S25-26-CMOS-Detector-Readout-System/S25-26-kicad/S25-26.kicad_pcb

## KiCad design S25-26.kicad_pcb (2025-04-30)

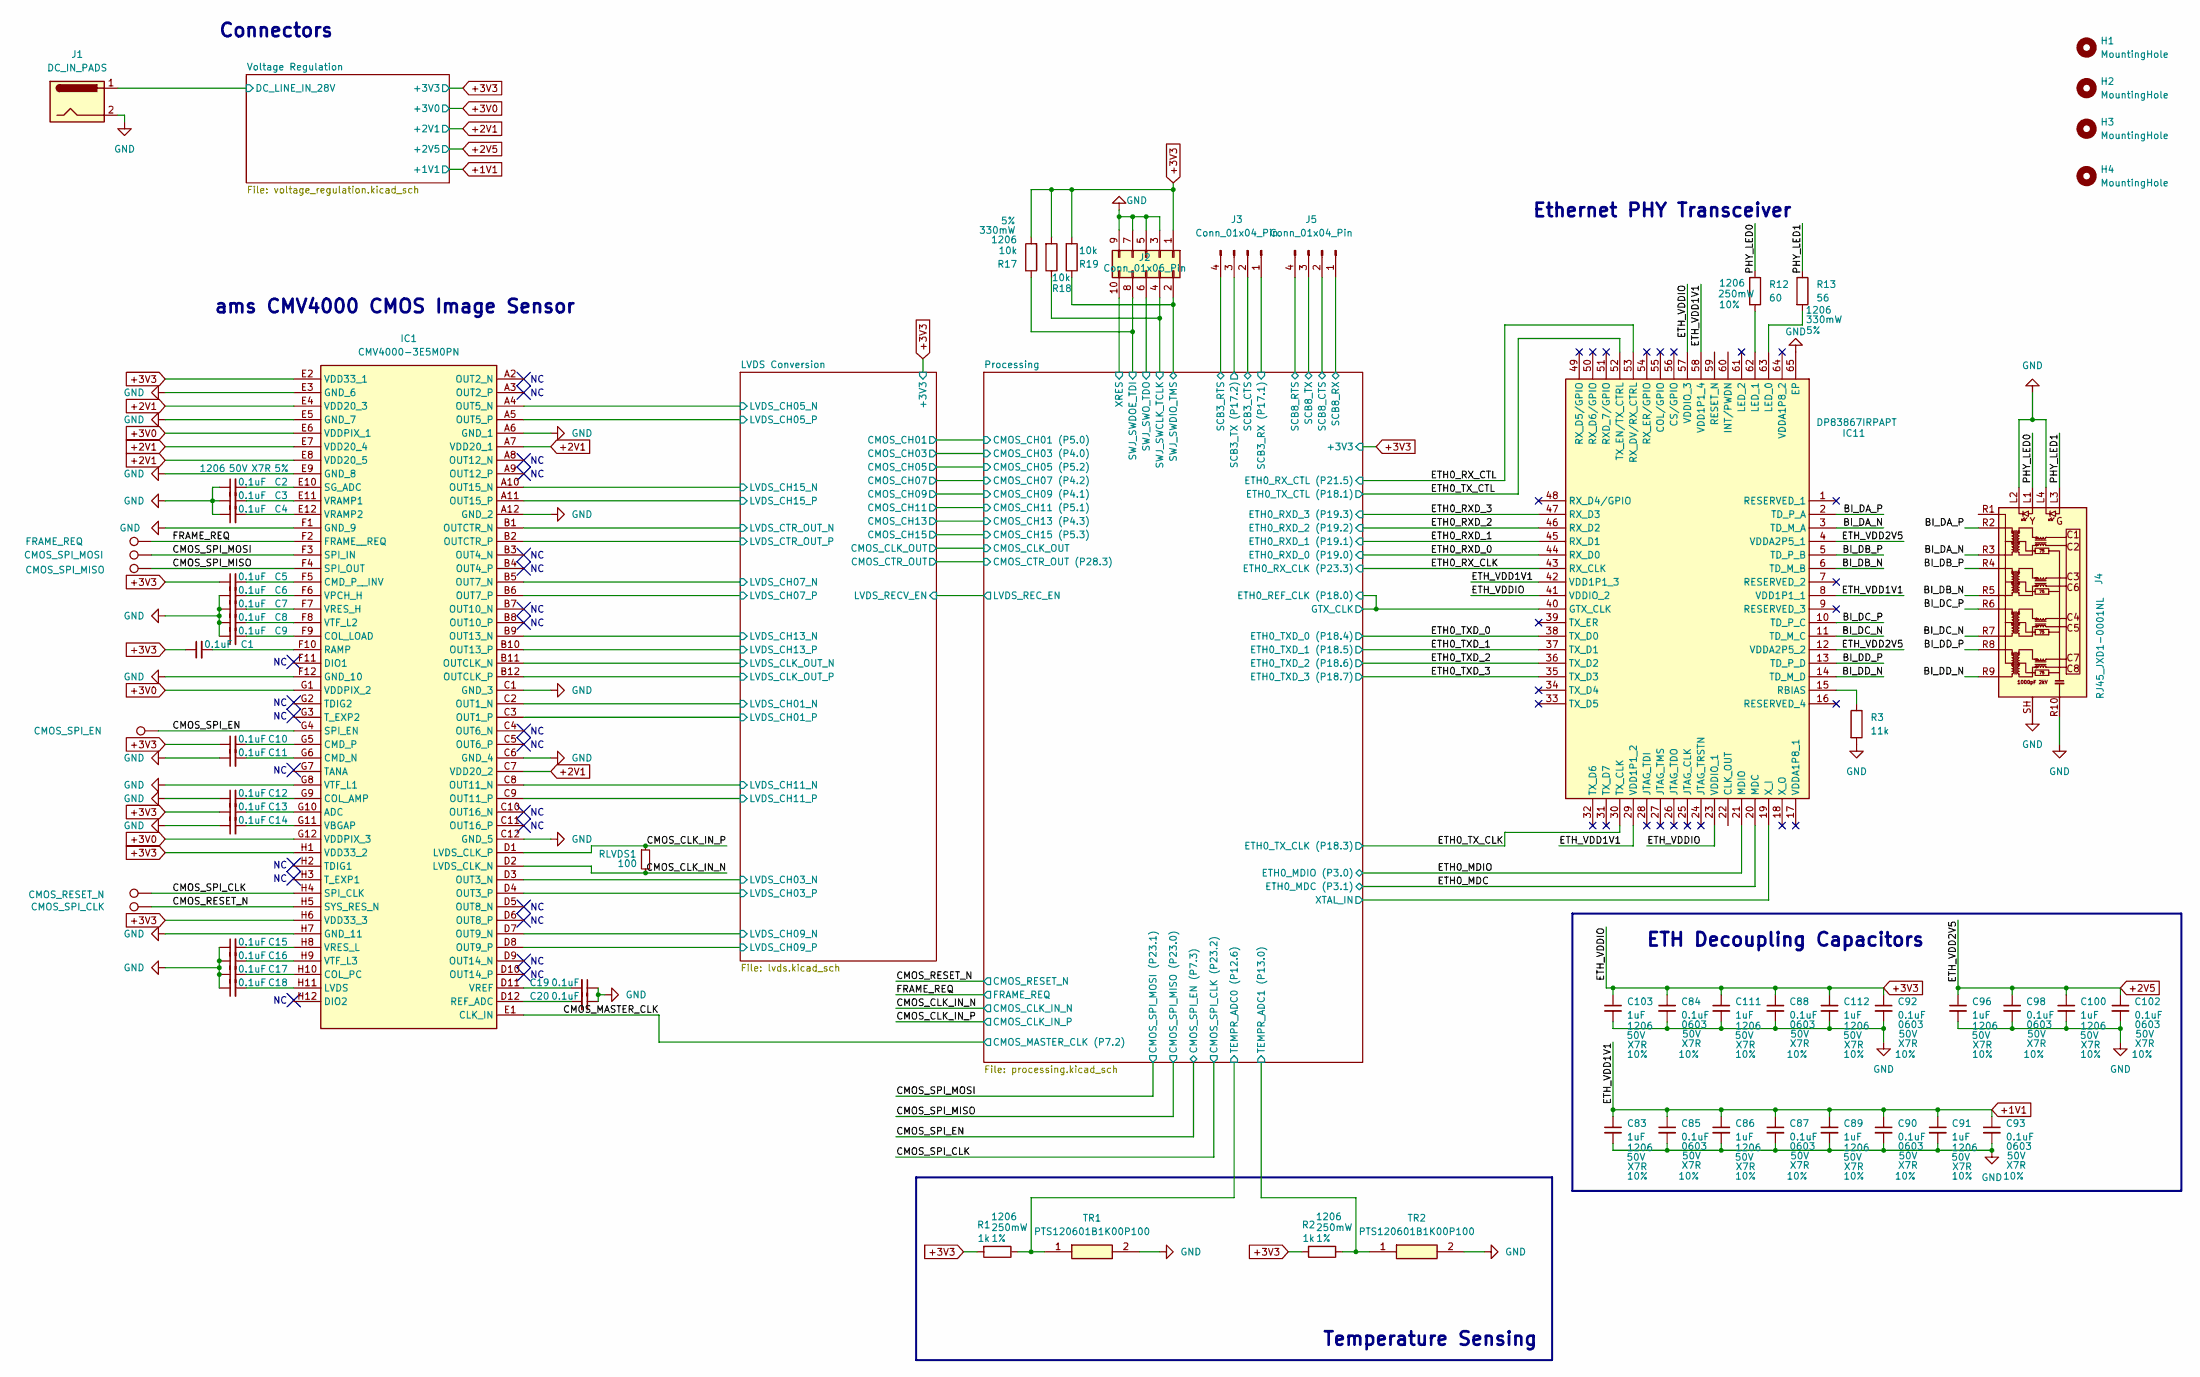
[picture p1: schematic S25-26.kicad_sch, S25-26: CMOS Detector Small Satellite Readout System]

Parts:
C1, C2, C3, C4, C5, C6, C7, C8, C9, C10, C11, C12, C13, C14, C15, C16, C17, C18, C19, C20: 0.1uF; C_1206_3216Metric; Voltage Rating 50V; Tolerance 5%; Mouser Part Number 581-12065C104J4Z2A
C83, C86, C89, C91, C96, C100, C103, C111, C112: 1uF; C_1206_3216Metric; Voltage Rating 50V; Tolerance 10%; Mouser Part Number 963-UMK316B7105KL-T
C84, C85, C87, C88, C90, C92, C93, C98, C102: 0.1uF; C_0603_1608Metric; Voltage Rating 50V; Tolerance 10%; Mouser Part Number 963-UMK107B7104KAHT
CMOS_RESET_N1: CMOS_RESET_N; TestPoint_Pad_2.0x2.0mm
CMOS_SCLK1: CMOS_SPI_CLK; TestPoint_Pad_2.0x2.0mm
CMOS_SPI_EN1: CMOS_SPI_EN; TestPoint_Pad_2.0x2.0mm
CMOS_SPI_MISO1: CMOS_SPI_MISO; TestPoint_Pad_2.0x2.0mm
CMOS_SPI_MOSI1: CMOS_SPI_MOSI; TestPoint_Pad_2.0x2.0mm
FRAME_REQ1: FRAME_REQ; TestPoint_Pad_2.0x2.0mm
H1, H2, H3, H4: MountingHole; MountingHole_2.7mm_Keepout
IC1: CMV4000-3E5M0PN; CMV40003E5M0PN_Socket; Manufacturer_Part_Number CMV4000-3E5M0PN
IC11: DP83867IRPAPT; QFP50P1200X1200X120-65N; Mouser Part Number 595-DP83867IRPAPT
J1: DC_IN_PADS; SolderWire-2sqmm_1x02_P7.8mm_D2mm_OD3.9mm
J2: Conn_01x06_Pin; PinHeader_2x05_P1.27mm_Vertical_SMD
J3, J5: Conn_01x04_Pin; PinHeader_1x04_P2.54mm_Vertical
J4: RJ45_JXD1-0001NL; Digikey Part Number 553-3266-ND
R1, R2: 1k; R_1206_3216Metric; Power Rating 250mW; Tolerance 1%; Mouser Part Number 71-RCA12061K00FKEA
R3: 11k; R_1206_3216Metric
R12: 60; R_1206_3216Metric; Power Rating 250mW; Tolerance 10%; Mouser Part Number 71-CRCW120660R0KNAIF
R13: 56; R_1206_3216Metric; Power Rating 330mW; Tolerance 5%; Mouser Part Number 667-ERJ-T08J560V
R17, R18, R19: 10k; R_1206_3216Metric; Power Rating 330mW; Tolerance 5%; Mouser Part Number 667-ERJ-T08J103V
RLVDS1: 100; R_0603_1608Metric; Power Rating 0.2W; Tolerance 1%; Mouser Part Number 667-ERJ-P03F1000V
TR1, TR2: PTS120601B1K00P100; RESC3016X65N; Manufacturer_Part_Number PTS120601B1K00P100; Mouser Part Number 594-PTS120601B1K00P

Connections:
+1V1: C83.1, C85.1, C86.1, C87.1, C89.1, C90.1, C91.1, C93.1, IC11.8 (VDD1P1_1), IC11.29 (VDD1P1_2), IC11.42 (VDD1P1_3), IC11.58 (VDD1P1_4); also elsewhere on the board
+2V1: IC1.A7 (VDD20_1), IC1.C7 (VDD20_2), IC1.E4 (VDD20_3), IC1.E7 (VDD20_4), IC1.E8 (VDD20_5); also elsewhere on the board
+2V5: C96.1, C98.1, C100.1, C102.1, IC11.4 (VDDA2P5_1), IC11.12 (VDDA2P5_2); also elsewhere on the board
+3V0: IC1.E6 (VDDPIX_1), IC1.G1 (VDDPIX_2), IC1.G12 (VDDPIX_3); also elsewhere on the board
+3V3: C1.1, C5.1, C10.1, C13.1, C84.1, C88.1, C92.1, C103.1, C111.1, C112.1, IC1.E2 (VDD33_1), IC1.H1 (VDD33_2), IC1.H6 (VDD33_3), IC11.23 (VDDIO_1), IC11.41 (VDDIO_2), IC11.57 (VDDIO_3), J2.1, R1.2, R2.2, R17.2, R18.2, R19.2; also elsewhere on the board
/BI_DA_N: IC11.3 (TD_M_A), J4.R3 (TD1-)
/BI_DA_P: IC11.2 (TD_P_A), J4.R2 (TD1+)
/BI_DB_N: IC11.6 (TD_M_B), J4.R5 (TD2-)
/BI_DB_P: IC11.5 (TD_P_B), J4.R4 (TD2+)
/BI_DC_N: IC11.11 (TD_M_C), J4.R7 (TD3-)
/BI_DC_P: IC11.10 (TD_P_C), J4.R6 (TD3+)
/BI_DD_N: IC11.14 (TD_M_D), J4.R9 (TD4-)
/BI_DD_P: IC11.13 (TD_P_D), J4.R8 (TD4+)
/CMOS_CLK_IN_N: IC1.D2 (LVDS_CLK_N), RLVDS1.2; also elsewhere on the board
/CMOS_CLK_IN_P: IC1.D1 (LVDS_CLK_P), RLVDS1.1; also elsewhere on the board
/CMOS_MASTER_CLK: IC1.E1 (CLK_IN); also elsewhere on the board
/CMOS_RESET_N: CMOS_SCLK1.1, IC1.H5 (SYS_RES_N); also elsewhere on the board
/CMOS_SPI_CLK: CMOS_RESET_N1.1, IC1.H4 (SPI_CLK); also elsewhere on the board
/CMOS_SPI_EN: CMOS_SPI_EN1.1, IC1.G4 (SPI_EN); also elsewhere on the board
/CMOS_SPI_MISO: CMOS_SPI_MISO1.1, IC1.F4 (SPI_OUT); also elsewhere on the board
/CMOS_SPI_MOSI: CMOS_SPI_MOSI1.1, IC1.F3 (SPI_IN); also elsewhere on the board
/ETH0_MDC: IC11.20 (MDC); also elsewhere on the board
/ETH0_MDIO: IC11.21 (MDIO); also elsewhere on the board
/ETH0_RXD_0: IC11.44 (RX_D0); also elsewhere on the board
/ETH0_RXD_1: IC11.45 (RX_D1); also elsewhere on the board
/ETH0_RXD_2: IC11.46 (RX_D2); also elsewhere on the board
/ETH0_RXD_3: IC11.47 (RX_D3); also elsewhere on the board
/ETH0_RX_CLK: IC11.43 (RX_CLK); also elsewhere on the board
/ETH0_RX_CTL: IC11.53 (RX_DV/RX_CTRL); also elsewhere on the board
/ETH0_TXD_0: IC11.38 (TX_D0); also elsewhere on the board
/ETH0_TXD_1: IC11.37 (TX_D1); also elsewhere on the board
/ETH0_TXD_2: IC11.36 (TX_D2); also elsewhere on the board
/ETH0_TXD_3: IC11.35 (TX_D3); also elsewhere on the board
/ETH0_TX_CLK: IC11.30 (TX_CLK); also elsewhere on the board
/ETH0_TX_CTL: IC11.52 (TX_EN/TX_CTRL); also elsewhere on the board
/FRAME_REQ: FRAME_REQ1.1, IC1.F2 (FRAME__REQ); also elsewhere on the board
/LVDS Conversion/LVDS_CH01_N: IC1.C2 (OUT1_N); also elsewhere on the board
/LVDS Conversion/LVDS_CH01_P: IC1.C3 (OUT1_P); also elsewhere on the board
/LVDS Conversion/LVDS_CH03_N: IC1.D3 (OUT3_N); also elsewhere on the board
/LVDS Conversion/LVDS_CH03_P: IC1.D4 (OUT3_P); also elsewhere on the board
/LVDS Conversion/LVDS_CH05_N: IC1.A4 (OUT5_N); also elsewhere on the board
/LVDS Conversion/LVDS_CH05_P: IC1.A5 (OUT5_P); also elsewhere on the board
/LVDS Conversion/LVDS_CH07_N: IC1.B5 (OUT7_N); also elsewhere on the board
/LVDS Conversion/LVDS_CH07_P: IC1.B6 (OUT7_P); also elsewhere on the board
/LVDS Conversion/LVDS_CH09_N: IC1.D7 (OUT9_N); also elsewhere on the board
/LVDS Conversion/LVDS_CH09_P: IC1.D8 (OUT9_P); also elsewhere on the board
/LVDS Conversion/LVDS_CH11_N: IC1.C8 (OUT11_N); also elsewhere on the board
/LVDS Conversion/LVDS_CH11_P: IC1.C9 (OUT11_P); also elsewhere on the board
/LVDS Conversion/LVDS_CH13_N: IC1.B9 (OUT13_N); also elsewhere on the board
/LVDS Conversion/LVDS_CH13_P: IC1.B10 (OUT13_P); also elsewhere on the board
/LVDS Conversion/LVDS_CH15_N: IC1.A10 (OUT15_N); also elsewhere on the board
/LVDS Conversion/LVDS_CH15_P: IC1.A11 (OUT15_P); also elsewhere on the board
/LVDS Conversion/LVDS_CLK_OUT_N: IC1.B11 (OUTCLK_N); also elsewhere on the board
/LVDS Conversion/LVDS_CLK_OUT_P: IC1.B12 (OUTCLK_P); also elsewhere on the board
/LVDS Conversion/LVDS_CTR_OUT_N: IC1.B1 (OUTCTR_N); also elsewhere on the board
/LVDS Conversion/LVDS_CTR_OUT_P: IC1.B2 (OUTCTR_P); also elsewhere on the board
/PHY_LED0: J4.L1, R12.1
/PHY_LED1: J4.L3, R13.1
/Processing/ETH0_REF_CLK (P18.0): IC11.40 (GTX_CLK); also elsewhere on the board
/Processing/SCB3_CTS: J3.2; also elsewhere on the board
/Processing/SCB3_RTS: J3.4; also elsewhere on the board
/Processing/SCB3_RX (P17.1): J3.1; also elsewhere on the board
/Processing/SCB3_TX (P17.2): J3.3; also elsewhere on the board
/Processing/SCB8_CTS: J5.2; also elsewhere on the board
/Processing/SCB8_RTS: J5.4; also elsewhere on the board
/Processing/SCB8_RX: J5.1; also elsewhere on the board
/Processing/SCB8_TX: J5.3; also elsewhere on the board
/Processing/SWJ_SWCLK_TCLK: J2.4, R18.1; also elsewhere on the board
/Processing/SWJ_SWDIO_TMS: J2.2, R19.1; also elsewhere on the board
/Processing/SWJ_SWDOE_TDI: J2.8, R17.1; also elsewhere on the board
/Processing/SWJ_SWO_TDO: J2.6; also elsewhere on the board
/Processing/TEMPR_ADC0 (P12.6): R1.1, TR1.1; also elsewhere on the board
/Processing/TEMPR_ADC1 (P13.0): R2.1, TR2.1; also elsewhere on the board
/Processing/XRES: J2.10; also elsewhere on the board
/Processing/XTAL_IN: IC11.19 (X_I); also elsewhere on the board
/Voltage Regulation/DC_LINE_IN_28V: J1.1; also elsewhere on the board
GND: C2.1, C3.1, C4.1, C6.1, C7.1, C8.1, C9.1, C11.1, C12.1, C14.1, C15.1, C16.1, C17.1, C18.1, C19.1, C20.1, C83.2, C84.2, C85.2, C86.2, C87.2, C88.2, C89.2, C90.2, C91.2, C92.2, C93.2, C96.2, C98.2, C100.2, C102.2, C103.2, C111.2, C112.2, IC1.A6 (GND_1), IC1.A12 (GND_2), IC1.C1 (GND_3), IC1.C6 (GND_4), IC1.C12 (GND_5), IC1.E3 (GND_6), IC1.E5 (GND_7), IC1.E9 (GND_8), IC1.F1 (GND_9), IC1.F12 (GND_10), IC1.G8 (VTF_L1), IC1.H7 (GND_11), IC11.65 (EP), J1.2, J2.3, J2.5, J2.7, J2.9, J4.L2, J4.L4, J4.R10 (GND), J4.SH, R3.2, TR1.2, TR2.2; also elsewhere on the board
unnamed: C13.2, IC1.G10 (ADC)
unnamed: C11.2, IC1.G6 (CMD_N)
unnamed: C10.2, IC1.G5 (CMD_P)
unnamed: C5.2, IC1.F5 (CMD_P__INV)
unnamed: C12.2, IC1.G9 (COL_AMP)
unnamed: C9.2, IC1.F9 (COL_LOAD)
unnamed: C17.2, IC1.H10 (COL_PC)
unnamed: C18.2, IC1.H11 (LVDS)
unnamed: C1.2, IC1.F10 (RAMP)
unnamed: C20.2, IC1.D12 (REF_ADC)
unnamed: C2.2, IC1.E10 (SG_ADC)
unnamed: C14.2, IC1.G11 (VBGAP)
unnamed: C6.2, IC1.F6 (VPCH_H)
unnamed: C3.2, IC1.E11 (VRAMP1)
unnamed: C4.2, IC1.E12 (VRAMP2)
unnamed: C19.2, IC1.D11 (VREF)
unnamed: C7.2, IC1.F7 (VRES_H)
unnamed: C15.2, IC1.H8 (VRES_L)
unnamed: C8.2, IC1.F8 (VTF_L2)
unnamed: C16.2, IC1.H9 (VTF_L3)
unnamed: IC11.63 (LED_0), R13.2
unnamed: IC11.62 (LED_1), R12.2
unnamed: IC11.15 (RBIAS), R3.1

Notes on the sheet:
ams CMV4000 CMOS Image Sensor
Ethernet PHY Transceiver
Connectors
ETH Decoupling Capacitors
Temperature Sensing

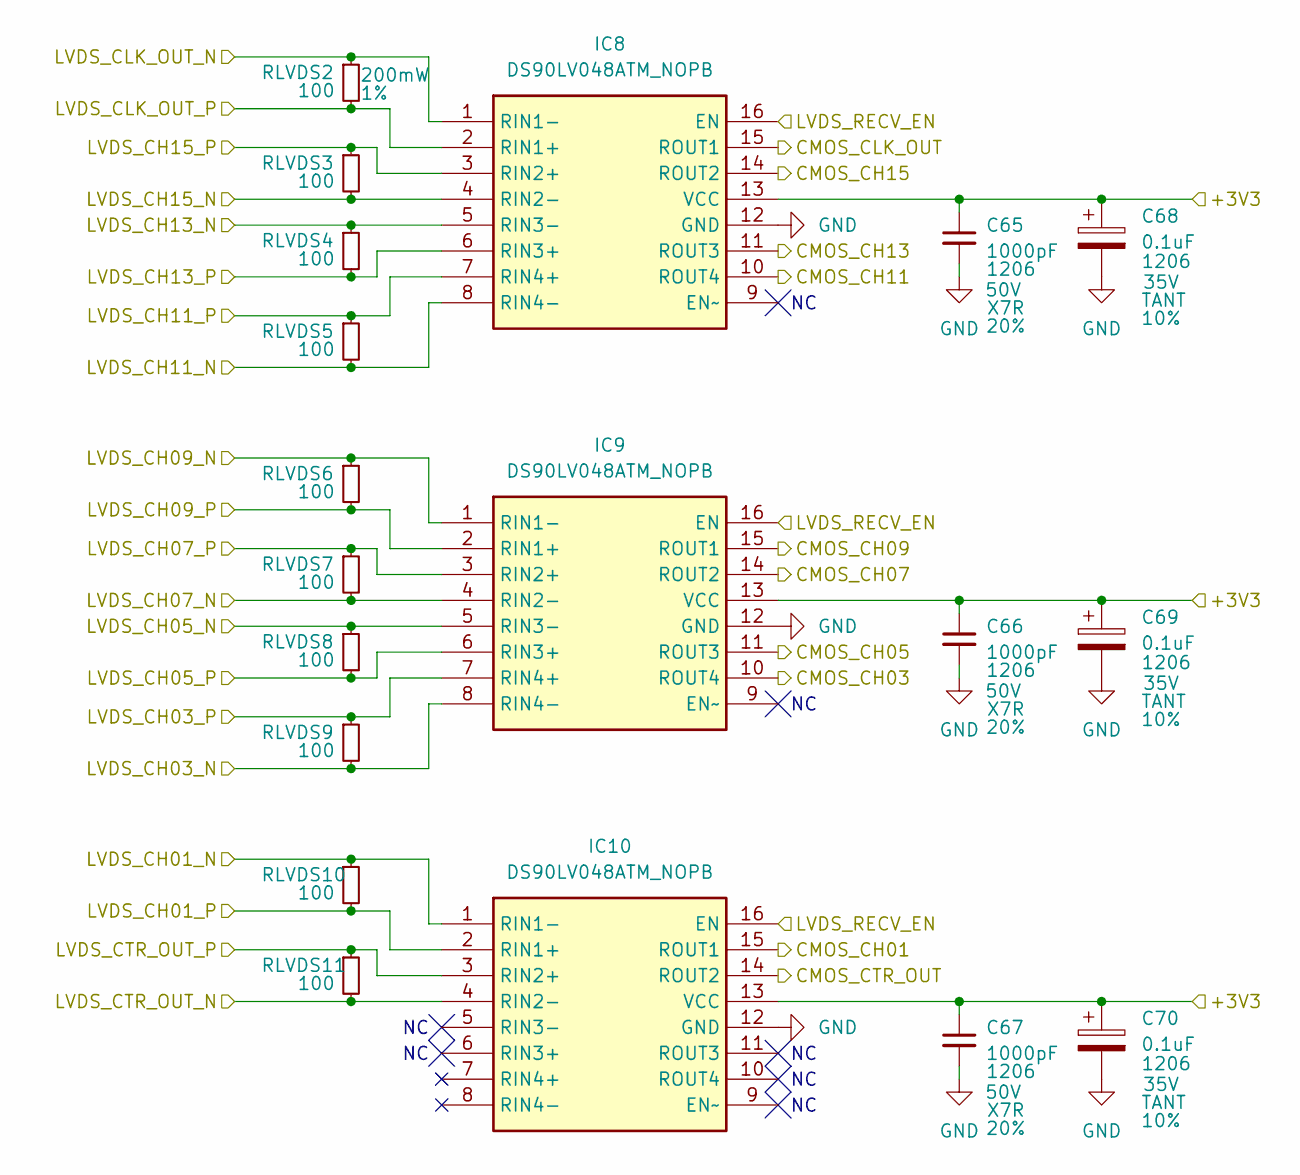
[picture p2: schematic lvds.kicad_sch]

Parts:
C65, C66, C67: 1000pF; C_1206_3216Metric; Voltage Rating 50V; Tolerance 20%; Mouser Part Number 80-C1206C102M5RACTM
C68, C69, C70: 0.1uF; C_1206_3216Metric; Voltage Rating 35V; Tolerance 10%; Mouser Part Number 581-TAJA104K035SNJ
IC8, IC9, IC10: DS90LV048ATM_NOPB; SOIC127P600X175-16N; Manufacturer_Part_Number DS90LV048ATM/NOPB; Mouser Part Number :926-DS90LV048ATMNOPB
RLVDS2: 100; R_0603_1608Metric; Power Rating 200mW; Tolerance 1%; Mouser Part Number 667-ERJ-P03F1000V
RLVDS3, RLVDS4, RLVDS5, RLVDS6, RLVDS7, RLVDS8, RLVDS9, RLVDS10, RLVDS11: 100; R_0603_1608Metric; Power Rating 0.2W; Tolerance 1%; Mouser Part Number 667-ERJ-P03F1000V

Connections:
+3V3: C65.1, C66.1, C67.1, C68.1, C69.1, C70.1, IC8.13 (VCC), IC9.13 (VCC), IC10.13 (VCC); also elsewhere on the board
/LVDS Conversion/CMOS_CH01: IC10.15 (ROUT1); also elsewhere on the board
/LVDS Conversion/CMOS_CH03: IC9.10 (ROUT4); also elsewhere on the board
/LVDS Conversion/CMOS_CH05: IC9.11 (ROUT3); also elsewhere on the board
/LVDS Conversion/CMOS_CH07: IC9.14 (ROUT2); also elsewhere on the board
/LVDS Conversion/CMOS_CH09: IC9.15 (ROUT1); also elsewhere on the board
/LVDS Conversion/CMOS_CH11: IC8.10 (ROUT4); also elsewhere on the board
/LVDS Conversion/CMOS_CH13: IC8.11 (ROUT3); also elsewhere on the board
/LVDS Conversion/CMOS_CH15: IC8.14 (ROUT2); also elsewhere on the board
/LVDS Conversion/CMOS_CLK_OUT: IC8.15 (ROUT1); also elsewhere on the board
/LVDS Conversion/CMOS_CTR_OUT: IC10.14 (ROUT2); also elsewhere on the board
/LVDS Conversion/LVDS_CH01_N: IC10.1 (RIN1-), RLVDS10.1; also elsewhere on the board
/LVDS Conversion/LVDS_CH01_P: IC10.2 (RIN1+), RLVDS10.2; also elsewhere on the board
/LVDS Conversion/LVDS_CH03_N: IC9.8 (RIN4-), RLVDS9.2; also elsewhere on the board
/LVDS Conversion/LVDS_CH03_P: IC9.7 (RIN4+), RLVDS9.1; also elsewhere on the board
/LVDS Conversion/LVDS_CH05_N: IC9.5 (RIN3-), RLVDS8.1; also elsewhere on the board
/LVDS Conversion/LVDS_CH05_P: IC9.6 (RIN3+), RLVDS8.2; also elsewhere on the board
/LVDS Conversion/LVDS_CH07_N: IC9.4 (RIN2-), RLVDS7.2; also elsewhere on the board
/LVDS Conversion/LVDS_CH07_P: IC9.3 (RIN2+), RLVDS7.1; also elsewhere on the board
/LVDS Conversion/LVDS_CH09_N: IC9.1 (RIN1-), RLVDS6.1; also elsewhere on the board
/LVDS Conversion/LVDS_CH09_P: IC9.2 (RIN1+), RLVDS6.2; also elsewhere on the board
/LVDS Conversion/LVDS_CH11_N: IC8.8 (RIN4-), RLVDS5.2; also elsewhere on the board
/LVDS Conversion/LVDS_CH11_P: IC8.7 (RIN4+), RLVDS5.1; also elsewhere on the board
/LVDS Conversion/LVDS_CH13_N: IC8.5 (RIN3-), RLVDS4.1; also elsewhere on the board
/LVDS Conversion/LVDS_CH13_P: IC8.6 (RIN3+), RLVDS4.2; also elsewhere on the board
/LVDS Conversion/LVDS_CH15_N: IC8.4 (RIN2-), RLVDS3.2; also elsewhere on the board
/LVDS Conversion/LVDS_CH15_P: IC8.3 (RIN2+), RLVDS3.1; also elsewhere on the board
/LVDS Conversion/LVDS_CLK_OUT_N: IC8.1 (RIN1-), RLVDS2.1; also elsewhere on the board
/LVDS Conversion/LVDS_CLK_OUT_P: IC8.2 (RIN1+), RLVDS2.2; also elsewhere on the board
/LVDS Conversion/LVDS_CTR_OUT_N: IC10.4 (RIN2-), RLVDS11.2; also elsewhere on the board
/LVDS Conversion/LVDS_CTR_OUT_P: IC10.3 (RIN2+), RLVDS11.1; also elsewhere on the board
/LVDS Conversion/LVDS_RECV_EN: IC8.16 (EN), IC9.16 (EN), IC10.16 (EN); also elsewhere on the board
GND: C65.2, C66.2, C67.2, C68.2, C69.2, C70.2, IC8.12 (GND), IC9.12 (GND), IC10.12 (GND); also elsewhere on the board

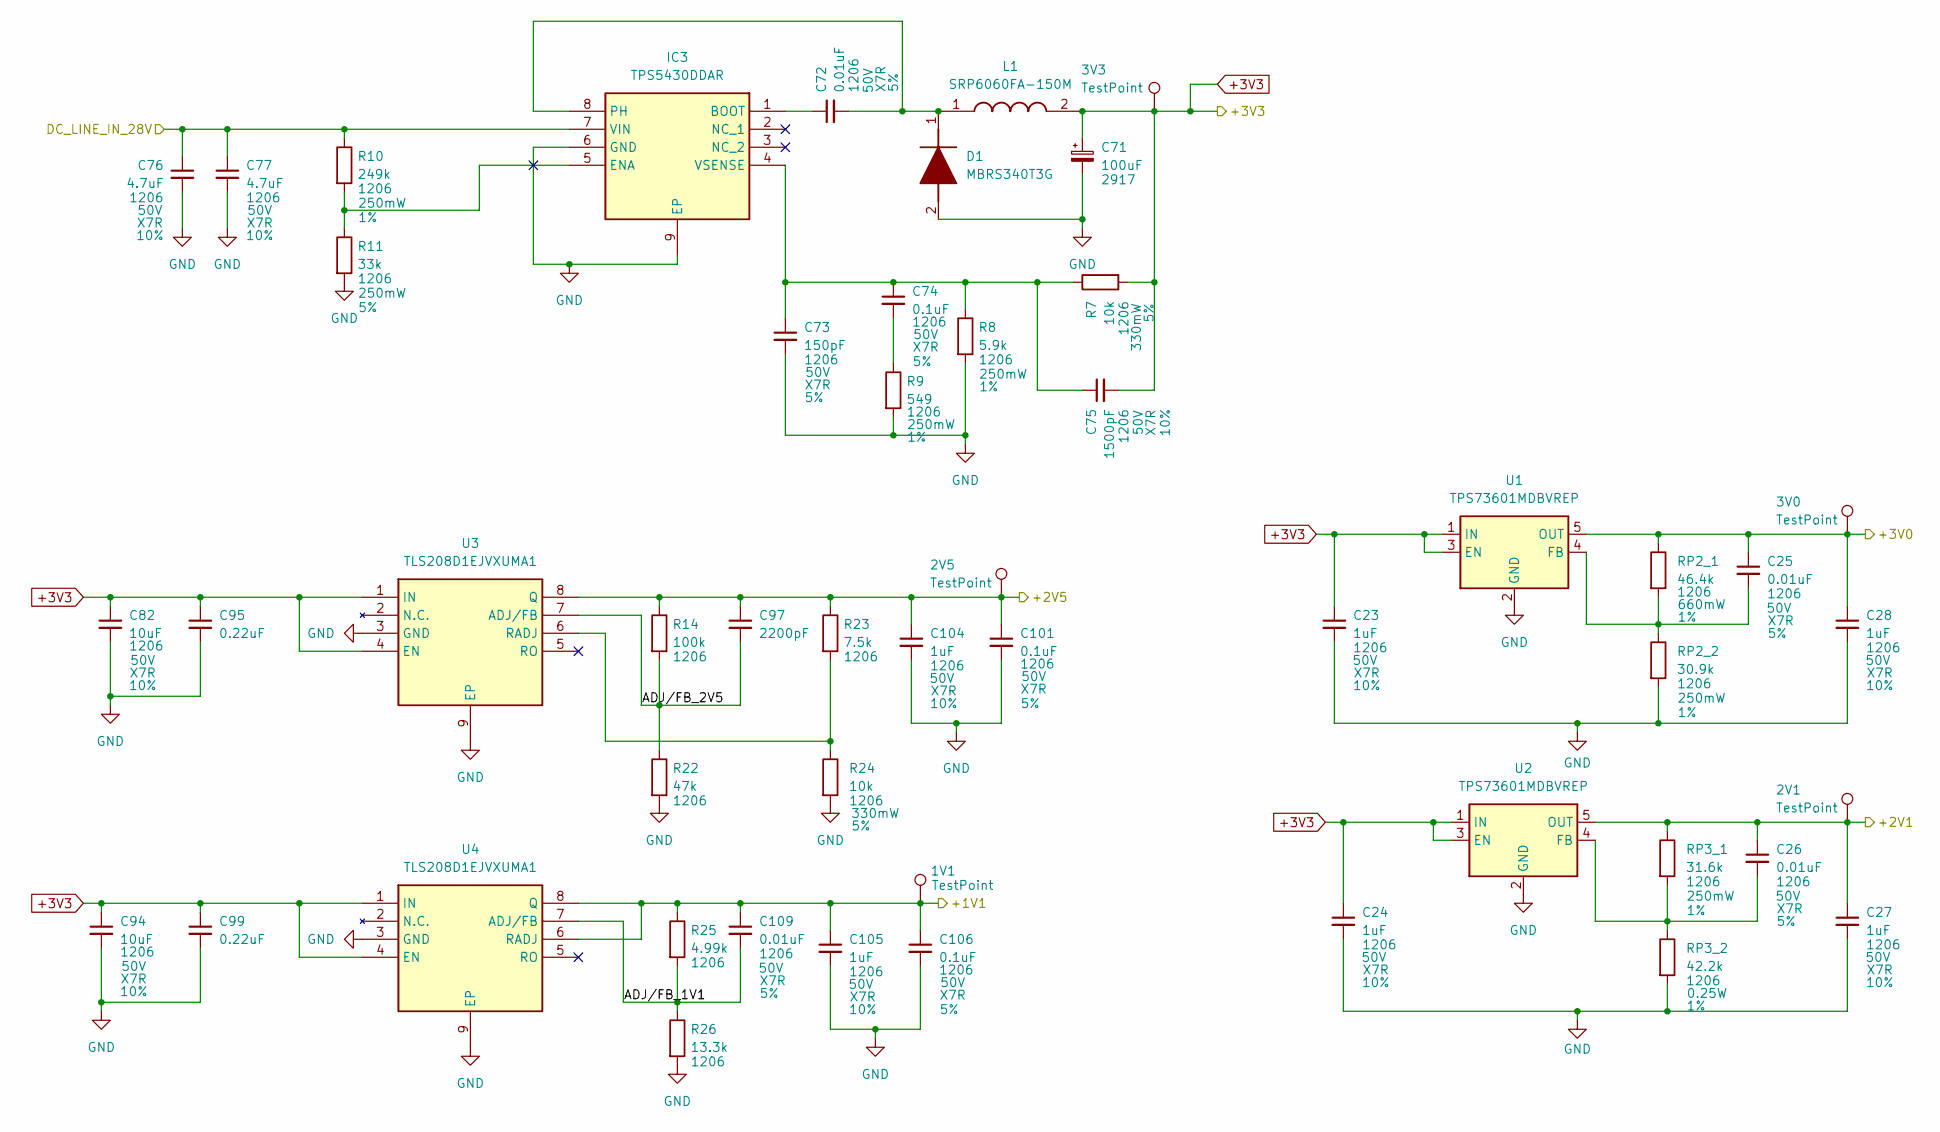
[picture p3: schematic voltage_regulation.kicad_sch]

Parts:
1V1, 2V1, 2V5, 3V0, 3V3: TestPoint; TestPoint_Pad_D1.0mm
C23, C24, C27, C28, C104, C105: 1uF; C_1206_3216Metric; Voltage Rating 50V; Tolerance 10%; Mouser Part Number 963-UMK316B7105KL-T
C25, C26, C72, C109: 0.01uF; C_1206_3216Metric; Voltage Rating 50V; Tolerance 5%; Mouser Part Number 581-12065C103J4T4A
C71: 100uF; CP_EIA-7343-15_Kemet-W; Mouser Part Number 74-293D107X9010D2TE3
C73: 150pF; C_1206_3216Metric; Voltage Rating 50V; Tolerance 5%; Mouser Part Number 80-C1206C151J5RACTU
C74, C101, C106: 0.1uF; C_1206_3216Metric; Voltage Rating 50V; Tolerance 5%; Mouser Part Number 581-12065C104J4Z2A
C75: 1500pF; C_1206_3216Metric; Voltage Rating 50V; Tolerance 10%; Mouser Part Number 77-VJ1206Y152KXAAC
C76, C77: 4.7uF; C_1206_3216Metric; Voltage Rating 50V; Tolerance 10%; Mouser Part Number 581-KGM31AR71H475KU
C82, C94: 10uF; C_1206_3216Metric; Voltage Rating 50V; Tolerance 10%; Mouser Part Number 187-CL31B106KBK6PJE
C95, C99: 0.22uF; C_1206_3216Metric
C97: 2200pF; C_1206_3216Metric
D1: MBRS340T3G; DIOM8059X261N; Mouser Part Number 863-MBRS340T3G
IC3: TPS5430DDAR; SOIC127P600X170-9N; Mouser Part Number 595-TPS5430DDAR
L1: SRP6060FA-150M; SRP6060FA150M; Mouser Part Number 652-SRP6060FA-150M
R7, R24: 10k; R_1206_3216Metric; Power Rating 330mW; Tolerance 5%; Mouser Part Number 667-ERJ-T08J103V
R8: 5.9k; R_1206_3216Metric; Power Rating 250mW; Tolerance 1%; Mouser Part Number 71-CRCW1206-5.9K-E3
R9: 549; R_1206_3216Metric; Power Rating 250mW; Tolerance 1%; Mouser Part Number 71-CRCW1206-549-E3
R10: 249k; R_1206_3216Metric; Power Rating 250mW; Tolerance 1%; Mouser Part Number 71-RCV1206249KFKEA
R11: 33k; R_1206_3216Metric; Power Rating 250mW; Tolerance 5%; Mouser Part Number 755-KTR18EZPJ333
R14: 100k; R_1206_3216Metric
R22: 47k; R_1206_3216Metric
R23: 7.5k; R_1206_3216Metric
R25: 4.99k; R_1206_3216Metric
R26: 13.3k; R_1206_3216Metric
RP2_1: 46.4k; R_1206_3216Metric; Power Rating 660mW; Tolerance 1%; Mouser Part Number 667-ERJ-P08F4642V
RP2_2: 30.9k; R_1206_3216Metric; Power Rating 250mW; Tolerance 1%; Mouser Part Number 652-CR1206FX-3092ELF
RP3_1: 31.6k; R_1206_3216Metric; Power Rating 250mW; Tolerance 1%; Mouser Part Number 71-CRCW120631K6FKEAC
RP3_2: 42.2k; R_1206_3216Metric; Power Rating 0.25W; Tolerance 1%; Mouser Part Number 71-CRCW1206-42.2K
U1, U2: TPS73601MDBVREP; SOT-23-5; Mouser Part Number 595-TPS73601MDBVREP
U3, U4: TLS208D1EJVXUMA1; SOIC127P600X170-9N; Mouser Part Number 726-TLS208D1EJVXUMA1

Connections:
+1V1: 1V1.1, C105.1, C106.1, C109.1, R25.1, U4.6 (RADJ), U4.8 (Q); also elsewhere on the board
+2V1: 2V1.1, C26.1, C27.1, RP3_1.1, U2.5 (OUT); also elsewhere on the board
+2V5: 2V5.1, C97.1, C101.1, C104.1, R14.1, R23.1, U3.8 (Q); also elsewhere on the board
+3V0: 3V0.1, C25.1, C28.1, RP2_1.1, U1.5 (OUT); also elsewhere on the board
+3V3: 3V3.1, C23.1, C24.1, C71.1, C75.2, C82.1, C94.1, C95.1, C99.1, L1.2, R7.2, U1.1 (IN), U1.3 (EN), U2.1 (IN), U2.3 (EN), U3.1 (IN), U3.4 (EN), U4.1 (IN), U4.4 (EN); also elsewhere on the board
/Voltage Regulation/ADJ/FB_1V1: C109.2, R25.2, R26.1, U4.7 (ADJ/FB)
/Voltage Regulation/ADJ/FB_2V5: C97.2, R14.2, R22.1, U3.7 (ADJ/FB)
/Voltage Regulation/DC_LINE_IN_28V: C76.1, C77.1, IC3.7 (VIN), R10.1; also elsewhere on the board
GND: C23.2, C24.2, C27.2, C28.2, C71.2, C73.2, C76.2, C77.2, C82.2, C94.2, C95.2, C99.2, C101.2, C104.2, C105.2, C106.2, D1.2 (A), IC3.6 (GND), IC3.9 (EP), R8.2, R9.2, R11.2, R22.2, R24.2, R26.2, RP2_2.2, RP3_2.2, U1.2 (GND), U2.2 (GND), U3.3 (GND), U3.9 (EP), U4.3 (GND), U4.9 (EP); also elsewhere on the board
unnamed: C74.2, R9.1
unnamed: C72.2, D1.1 (K), IC3.8 (PH), L1.1
unnamed: C72.1, IC3.1 (BOOT)
unnamed: IC3.5 (ENA), R10.2, R11.1
unnamed: C73.1, C74.1, C75.1, IC3.4 (VSENSE), R7.1, R8.1
unnamed: C25.2, RP2_1.2, RP2_2.1, U1.4 (FB)
unnamed: C26.2, RP3_1.2, RP3_2.1, U2.4 (FB)
unnamed: R23.2, R24.1, U3.6 (RADJ)
