S25-26-CMOS-Detector-Readout-System/S25-26-kicad/S25-26.kicad_pcb

## KiCad design S25-26.kicad_pcb (continued)

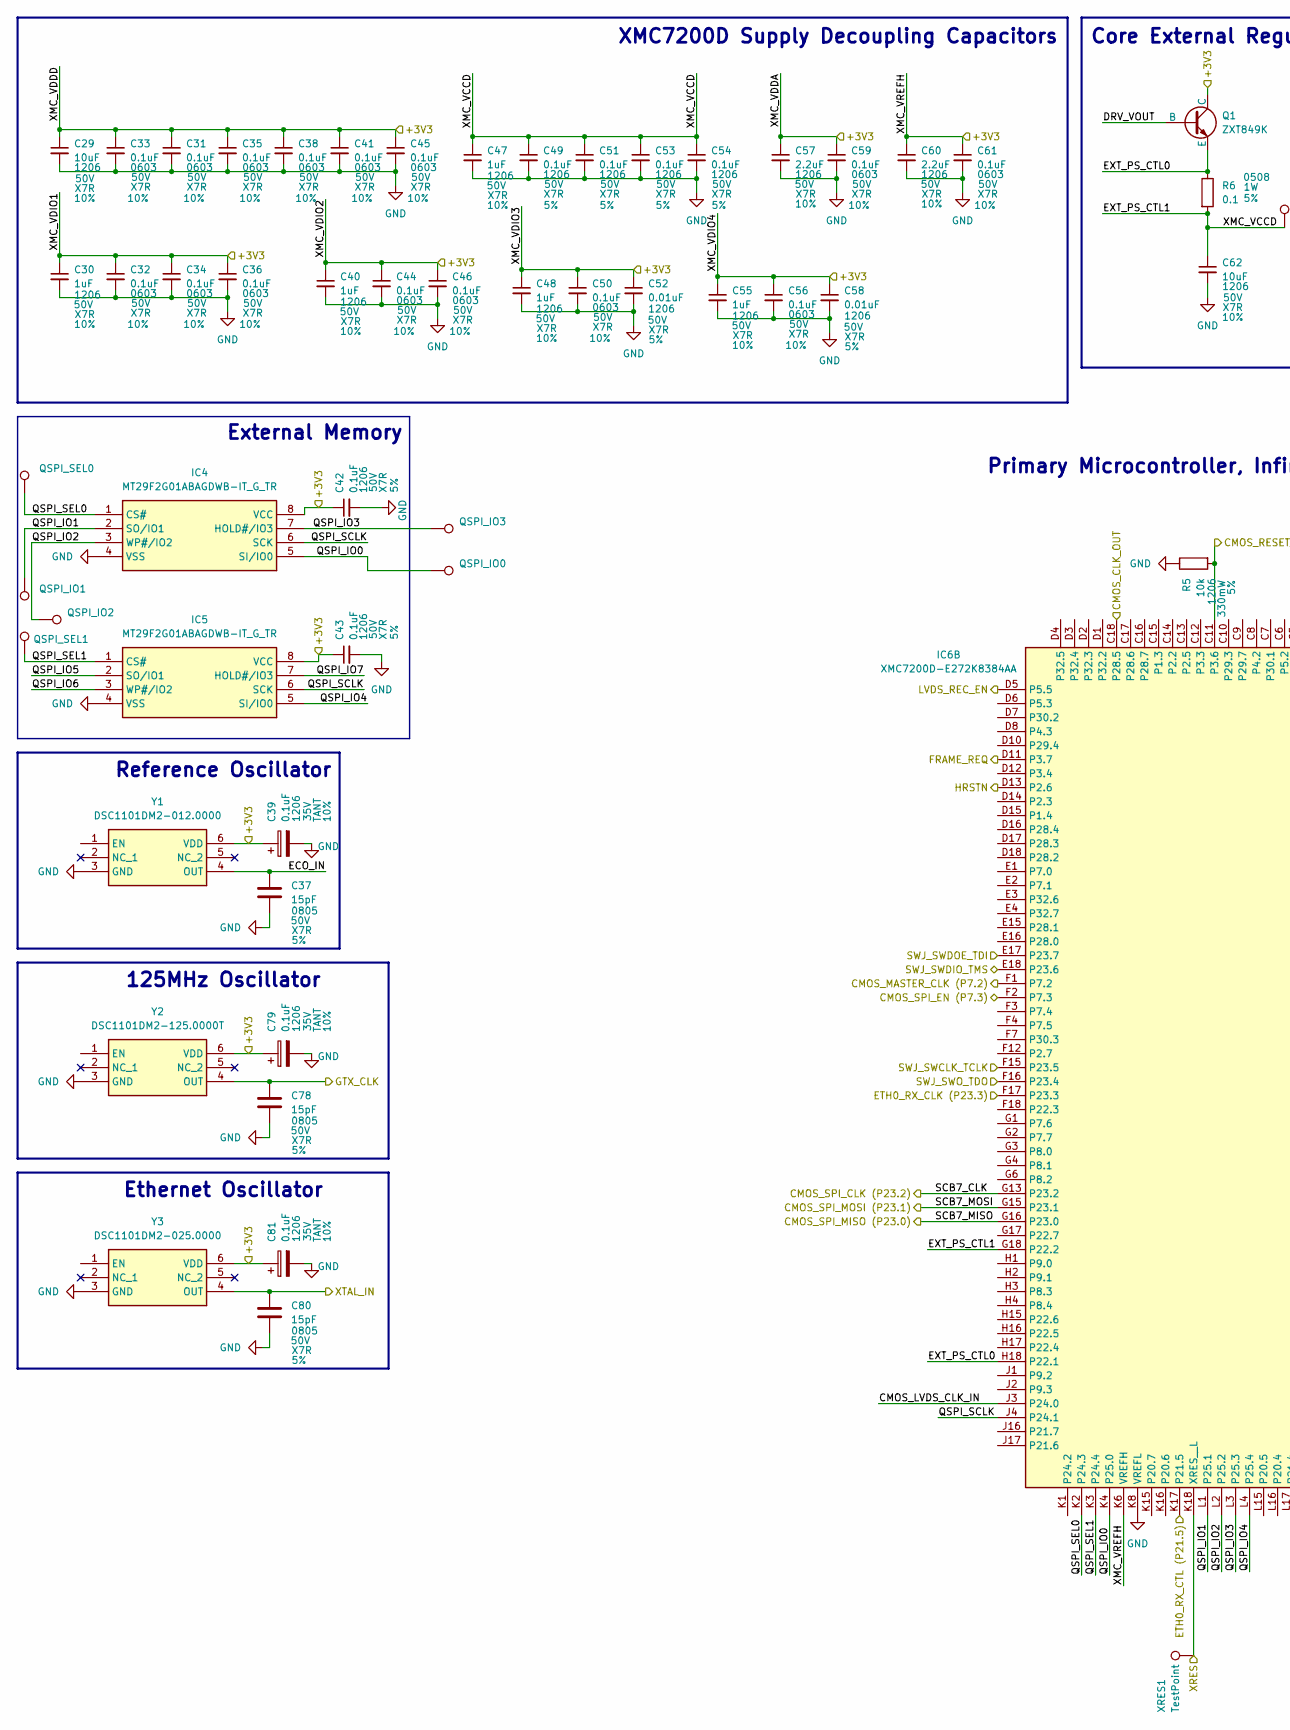
[picture p4: schematic processing.kicad_sch, part in row 1, column 1]

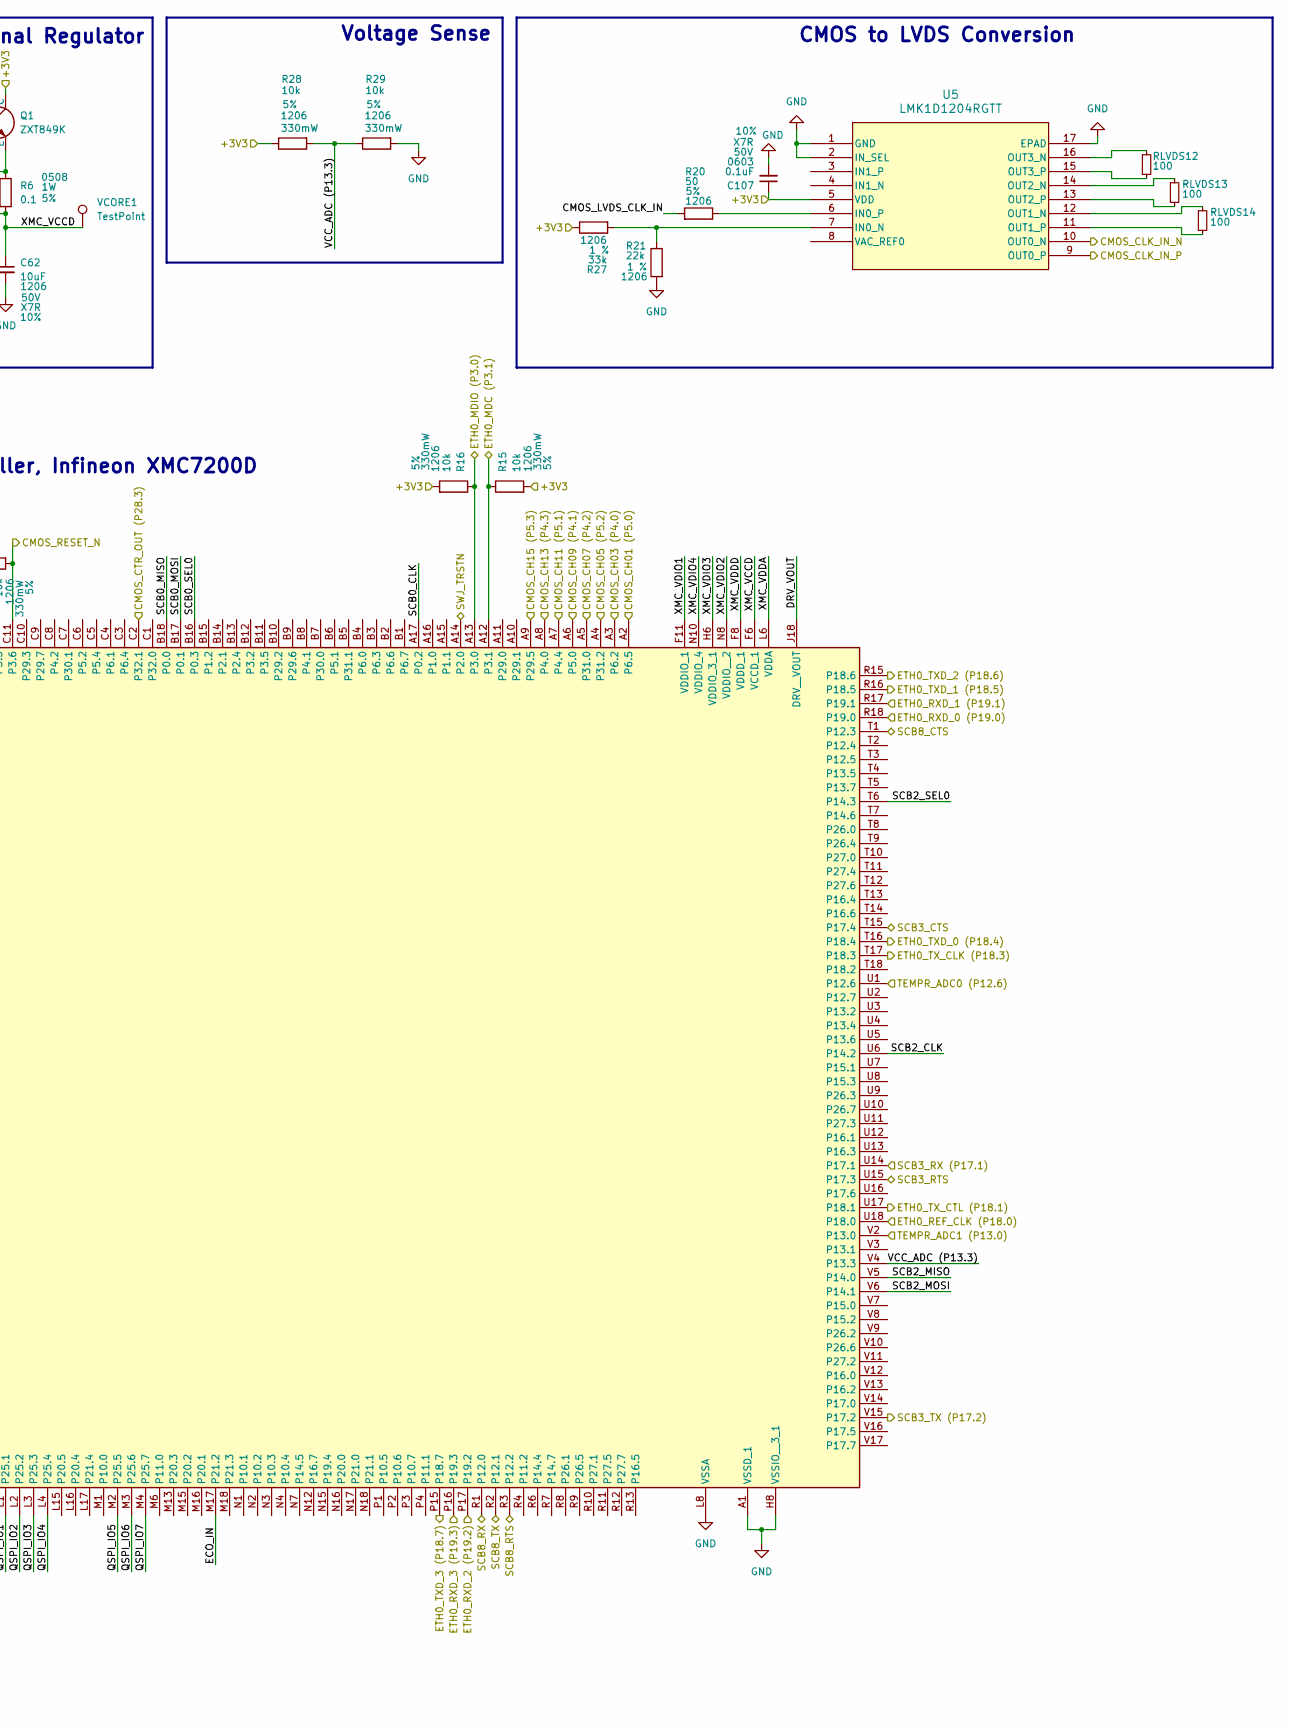
[picture p5: schematic processing.kicad_sch, part in row 1, column 2]

Parts:
C29, C62: 10uF; C_1206_3216Metric; Voltage Rating 50V; Tolerance 10%; Mouser Part Number 187-CL31B106KBK6PJE
C30, C40, C47, C48, C55: 1uF; C_1206_3216Metric; Voltage Rating 50V; Tolerance 10%; Mouser Part Number 963-UMK316B7105KL-T
C31, C32, C33, C34, C35, C36, C38, C41, C44, C45, C46, C50, C56, C59, C61, C107: 0.1uF; C_0603_1608Metric; Voltage Rating 50V; Tolerance 10%; Mouser Part Number 963-UMK107B7104KAHT
C37, C78, C80: 15pF; C_0805_2012Metric; Voltage Rating 50V; Tolerance 5%; Mouser Part Number 80-C0805C150J5RACTU
C39, C79, C81: 0.1uF; C_1206_3216Metric; Voltage Rating 35V; Tolerance 10%; Mouser Part Number 581-TAJA104K035SNJ
C42, C43, C49, C51, C53, C54: 0.1uF; C_1206_3216Metric; Voltage Rating 50V; Tolerance 5%; Mouser Part Number 581-12065C104J4Z2A
C52, C58: 0.01uF; C_1206_3216Metric; Voltage Rating 50V; Tolerance 5%; Mouser Part Number 581-12065C103J4T4A
C57, C60: 2.2uF; C_1206_3216Metric; Voltage Rating 50V; Tolerance 10%; Mouser Part Number 80-C1206X225K5REAULR
IC4, IC5: MT29F2G01ABAGDWB-IT_G_TR; SON127P800X600X65-8N; Manufacturer_Part_Number MT29F2G01ABAGDWB-IT:G TR; Mouser Part Number 340-319922-REEL
IC6: XMC7200D-E272K8384AA; BGA272C80P18X18_1600X1600X170; Manufacturer_Part_Number XMC7200D-E272K8384AA; Mouser Part Number 726-C7200DE272K8384A
Q1: ZXT849K; TO-252-3_TabPin4; Mouser Part Number 522-ZXT849KTC
QSPI_IO0: QSPI_IO0; TestPoint_Pad_2.0x2.0mm
QSPI_IO1: QSPI_IO1; TestPoint_Pad_2.0x2.0mm
QSPI_IO2: QSPI_IO2; TestPoint_Pad_2.0x2.0mm
QSPI_IO3: QSPI_IO3; TestPoint_Pad_2.0x2.0mm
QSPI_SEL0: QSPI_SEL0; TestPoint_Pad_2.0x2.0mm
QSPI_SEL1: QSPI_SEL1; TestPoint_Pad_2.0x2.0mm
R5, R15, R16, R28, R29: 10k; R_1206_3216Metric; Power Rating 330mW; Tolerance 5%; Mouser Part Number 667-ERJ-T08J103V
R6: 0.1; R_1206_3216Metric; Power Rating 1W; Tolerance 5%; Mouser Part Number 755-LTR10LEZPJLR10
R20: 50; R_1206_3216Metric; Tolerance 5%
R21: 22k; R_1206_3216Metric; Tolerance 1 %
R27: 33k; R_1206_3216Metric; Tolerance 1 %
RLVDS12, RLVDS13, RLVDS14: 100; R_0603_1608Metric; Power Rating 0.2W; Tolerance 1%; Mouser Part Number 667-ERJ-P03F1000V
U5: LMK1D1204RGTT; VQFN16_RGT_TEX; Digikey Part Number 296-LMK1D1204RGTTCT-ND
VCORE1: TestPoint; TestPoint_Pad_D1.0mm
XRES1: TestPoint; TestPoint_Pad_D1.0mm
Y1: DSC1101DM2-012.0000; DSC1101DM20120000; Manufacturer_Part_Number DSC1101DM2-012.0000; Mouser Part Number 579-DSC1101DM2012
Y2: DSC1101DM2-125.0000T; DSC1101DM20120000; Manufacturer_Part_Number DSC1101DM2-125.0000T; Mouser Part Number 998-1101DM2125.0000T
Y3: DSC1101DM2-025.0000; DSC1101DM20120000; Manufacturer_Part_Number DSC1101DM2-025.0000; Mouser Part Number 998-1101DM2025.0000

Connections:
+3V3: C29.1, C30.1, C31.1, C32.1, C33.1, C34.1, C35.1, C36.1, C38.1, C39.1, C40.1, C41.1, C42.1, C43.1, C44.1, C45.1, C46.1, C48.1, C50.1, C52.1, C55.1, C56.1, C57.1, C58.1, C59.1, C60.1, C61.1, C79.1, C81.1, C107.1, IC4.8 (VCC), IC5.8 (VCC), IC6.F8 (VDDD_1), IC6.F9 (VDDIO__1_1), IC6.F10 (VDDIO__1_2), IC6.F11 (VDDIO_1), IC6.H6 (VDDIO_3_1), IC6.H13 (VDDD_2), IC6.J6 (VDDIO_3_2), IC6.J13 (VDDD_3), IC6.K6 (VREFH), IC6.K13 (VDDD_4), IC6.L6 (VDDA), IC6.L13 (VDDD_5), IC6.N8 (VDDIO__2), IC6.N9 (VDDIO__4), IC6.N10 (VDDIO_4), IC6.N11 (VDDD_6), Q1.1 (C), R15.2, R16.2, R27.1, R28.1, U5.5 (VDD), Y1.6 (VDD), Y2.6 (VDD), Y3.6 (VDD); also elsewhere on the board
/CMOS_CLK_IN_N: U5.10 (OUT0_N); also elsewhere on the board
/CMOS_CLK_IN_P: U5.9 (OUT0_P); also elsewhere on the board
/CMOS_MASTER_CLK: IC6.F1 (P7.2); also elsewhere on the board
/CMOS_RESET_N: IC6.C11 (P3.6), R5.2; also elsewhere on the board
/CMOS_SPI_CLK: IC6.G13 (P23.2); also elsewhere on the board
/CMOS_SPI_EN: IC6.F2 (P7.3); also elsewhere on the board
/CMOS_SPI_MISO: IC6.G16 (P23.0); also elsewhere on the board
/CMOS_SPI_MOSI: IC6.G15 (P23.1); also elsewhere on the board
/ETH0_MDC: IC6.A12 (P3.1), R15.1; also elsewhere on the board
/ETH0_MDIO: IC6.A13 (P3.0), R16.1; also elsewhere on the board
/ETH0_RXD_0: IC6.R18 (P19.0); also elsewhere on the board
/ETH0_RXD_1: IC6.R17 (P19.1); also elsewhere on the board
/ETH0_RXD_2: IC6.P17 (P19.2); also elsewhere on the board
/ETH0_RXD_3: IC6.P16 (P19.3); also elsewhere on the board
/ETH0_RX_CLK: IC6.F17 (P23.3); also elsewhere on the board
/ETH0_RX_CTL: IC6.K17 (P21.5); also elsewhere on the board
/ETH0_TXD_0: IC6.T16 (P18.4); also elsewhere on the board
/ETH0_TXD_1: IC6.R16 (P18.5); also elsewhere on the board
/ETH0_TXD_2: IC6.R15 (P18.6); also elsewhere on the board
/ETH0_TXD_3: IC6.P15 (P18.7); also elsewhere on the board
/ETH0_TX_CLK: IC6.T17 (P18.3); also elsewhere on the board
/ETH0_TX_CTL: IC6.U17 (P18.1); also elsewhere on the board
/FRAME_REQ: IC6.D11 (P3.7); also elsewhere on the board
/LVDS Conversion/CMOS_CH01: IC6.A2 (P6.5); also elsewhere on the board
/LVDS Conversion/CMOS_CH03: IC6.A3 (P6.2); also elsewhere on the board
/LVDS Conversion/CMOS_CH05: IC6.A4 (P31.2); also elsewhere on the board
/LVDS Conversion/CMOS_CH07: IC6.A5 (P31.0); also elsewhere on the board
/LVDS Conversion/CMOS_CH09: IC6.A6 (P5.0); also elsewhere on the board
/LVDS Conversion/CMOS_CH11: IC6.A7 (P4.4); also elsewhere on the board
/LVDS Conversion/CMOS_CH13: IC6.A8 (P4.0); also elsewhere on the board
/LVDS Conversion/CMOS_CH15: IC6.A9 (P29.5); also elsewhere on the board
/LVDS Conversion/CMOS_CLK_OUT: IC6.C18 (P28.5); also elsewhere on the board
/LVDS Conversion/CMOS_CTR_OUT: IC6.C2 (P32.1); also elsewhere on the board
/LVDS Conversion/LVDS_RECV_EN: IC6.D5 (P5.5); also elsewhere on the board
/Processing/CMOS_LVDS_CLK_IN: IC6.J3 (P24.0), R20.2
/Processing/DRV_VOUT: IC6.J18 (DRV__VOUT), Q1.2 (B)
/Processing/ECO_IN: C37.1, IC6.M17 (P21.2), Y1.4 (OUT)
/Processing/ETH0_REF_CLK (P18.0): C78.1, IC6.U18 (P18.0), Y2.4 (OUT); also elsewhere on the board
/Processing/EXT_PS_CTL0: IC6.H18 (P22.1), Q1.3 (E), R6.1
/Processing/EXT_PS_CTL1: C47.1, C49.1, C51.1, C53.1, C54.1, C62.1, IC6.F6 (VCCD_1), IC6.F13 (VCCD_2), IC6.G18 (P22.2), IC6.N6 (VCCD_3), IC6.N13 (VCCD_4), R6.2, VCORE1.1
/Processing/HRSTN: IC6.D13 (P2.6)
/Processing/QSPI_IO0: IC4.5 (SI/IO0), IC6.K4 (P25.0), QSPI_IO0.1
/Processing/QSPI_IO1: IC4.2 (SO/IO1), IC6.L1 (P25.1), QSPI_IO1.1
/Processing/QSPI_IO2: IC4.3 (WP#/IO2), IC6.L2 (P25.2), QSPI_IO2.1
/Processing/QSPI_IO3: IC4.7 (HOLD#/IO3), IC6.L3 (P25.3), QSPI_IO3.1
/Processing/QSPI_IO4: IC5.5 (SI/IO0), IC6.L4 (P25.4)
/Processing/QSPI_IO5: IC5.2 (SO/IO1), IC6.M2 (P25.5)
/Processing/QSPI_IO6: IC5.3 (WP#/IO2), IC6.M3 (P25.6)
/Processing/QSPI_IO7: IC5.7 (HOLD#/IO3), IC6.M4 (P25.7)
/Processing/QSPI_SCLK: IC4.6 (SCK), IC5.6 (SCK), IC6.J4 (P24.1)
/Processing/QSPI_SEL0: IC4.1 (CS#), IC6.K2 (P24.3), QSPI_SEL0.1
/Processing/QSPI_SEL1: IC5.1 (CS#), IC6.K3 (P24.4), QSPI_SEL1.1
/Processing/SCB0_CLK: IC6.A17 (P0.2)
/Processing/SCB0_MISO: IC6.B18 (P0.0)
/Processing/SCB0_MOSI: IC6.B17 (P0.1)
/Processing/SCB0_SEL0: IC6.B16 (P0.3)
/Processing/SCB2_CLK: IC6.U6 (P14.2)
/Processing/SCB2_MISO: IC6.V5 (P14.0)
/Processing/SCB2_MOSI: IC6.V6 (P14.1)
/Processing/SCB2_SEL0: IC6.T6 (P14.3)
/Processing/SCB3_CTS: IC6.T15 (P17.4); also elsewhere on the board
/Processing/SCB3_RTS: IC6.U15 (P17.3); also elsewhere on the board
/Processing/SCB3_RX (P17.1): IC6.U14 (P17.1); also elsewhere on the board
/Processing/SCB3_TX (P17.2): IC6.V15 (P17.2); also elsewhere on the board
/Processing/SCB8_CTS: IC6.T1 (P12.3); also elsewhere on the board
/Processing/SCB8_RTS: IC6.R3 (P12.2); also elsewhere on the board
/Processing/SCB8_RX: IC6.R1 (P12.0); also elsewhere on the board
/Processing/SCB8_TX: IC6.R2 (P12.1); also elsewhere on the board
/Processing/SWJ_SWCLK_TCLK: IC6.F15 (P23.5); also elsewhere on the board
/Processing/SWJ_SWDIO_TMS: IC6.E18 (P23.6); also elsewhere on the board
/Processing/SWJ_SWDOE_TDI: IC6.E17 (P23.7); also elsewhere on the board
/Processing/SWJ_SWO_TDO: IC6.F16 (P23.4); also elsewhere on the board
/Processing/SWJ_TRSTN: IC6.A14 (P2.0)
/Processing/TEMPR_ADC0 (P12.6): IC6.U1 (P12.6); also elsewhere on the board
/Processing/TEMPR_ADC1 (P13.0): IC6.V2 (P13.0); also elsewhere on the board
/Processing/VCC_ADC (P13.3): IC6.V4 (P13.3), R28.2, R29.1
/Processing/XRES: IC6.K18 (XRES__L), XRES1.1; also elsewhere on the board
/Processing/XTAL_IN: C80.1, Y3.4 (OUT); also elsewhere on the board
GND: C29.2, C30.2, C31.2, C32.2, C33.2, C34.2, C35.2, C36.2, C37.2, C38.2, C39.2, C40.2, C41.2, C42.2, C43.2, C44.2, C45.2, C46.2, C47.2, C48.2, C49.2, C50.2, C51.2, C52.2, C53.2, C54.2, C55.2, C56.2, C57.2, C58.2, C59.2, C60.2, C61.2, C62.2, C78.2, C79.2, C80.2, C81.2, C107.2, IC4.4 (VSS), IC5.4 (VSS), IC6.A1 (VSSD_1), IC6.A18 (VSSD_2), IC6.D9 (VSSD_3), IC6.G7 (VSSD_4), IC6.G12 (VSSD_5), IC6.H8 (VSSIO__3_1), IC6.H9 (VSSD_6), IC6.H10 (VSSD_7), IC6.H11 (VSSD_8), IC6.J8 (VSSIO__3_2), IC6.J9 (VSSD_9), IC6.J10 (VSSD_10), IC6.J11 (VSSD_11), IC6.J15 (VSSD_12), IC6.K8 (VREFL), IC6.K9 (VSSD_13), IC6.K10 (VSSD_14), IC6.K11 (VSSD_15), IC6.L8 (VSSA), IC6.L9 (VSSIO__4_1), IC6.L10 (VSSIO__4_2), IC6.L11 (VSSD__1), IC6.L18 (VSSD__2_1), IC6.M7 (VSSD_16), IC6.M12 (VSSD_17), IC6.P18 (VSSD__2_2), IC6.R5 (VSSD_18), IC6.R14 (VSSD_19), IC6.V1 (VSSD_20), IC6.V18 (VSSD_21), R5.1, R21.2, R29.2, U5.1 (GND), U5.2 (IN_SEL), U5.17 (EPAD), Y1.3 (GND), Y2.3 (GND), Y3.3 (GND); also elsewhere on the board
unnamed: R21.1, R27.2, U5.7 (IN0_N)
unnamed: R20.1, U5.6 (IN0_P)
unnamed: RLVDS14.1, U5.12 (OUT1_N)
unnamed: RLVDS14.2, U5.11 (OUT1_P)
unnamed: RLVDS13.1, U5.14 (OUT2_N)
unnamed: RLVDS13.2, U5.13 (OUT2_P)
unnamed: RLVDS12.1, U5.16 (OUT3_N)
unnamed: RLVDS12.2, U5.15 (OUT3_P)

Notes on the sheet:
Voltage Sense
Ethernet Oscillator
125MHz Oscillator
External Memory
Reference Oscillator
XMC7200D Supply Decoupling Capacitors
CMOS to LVDS Conversion
Primary Microcontroller, Infineon XMC7200D
Core External Regulator

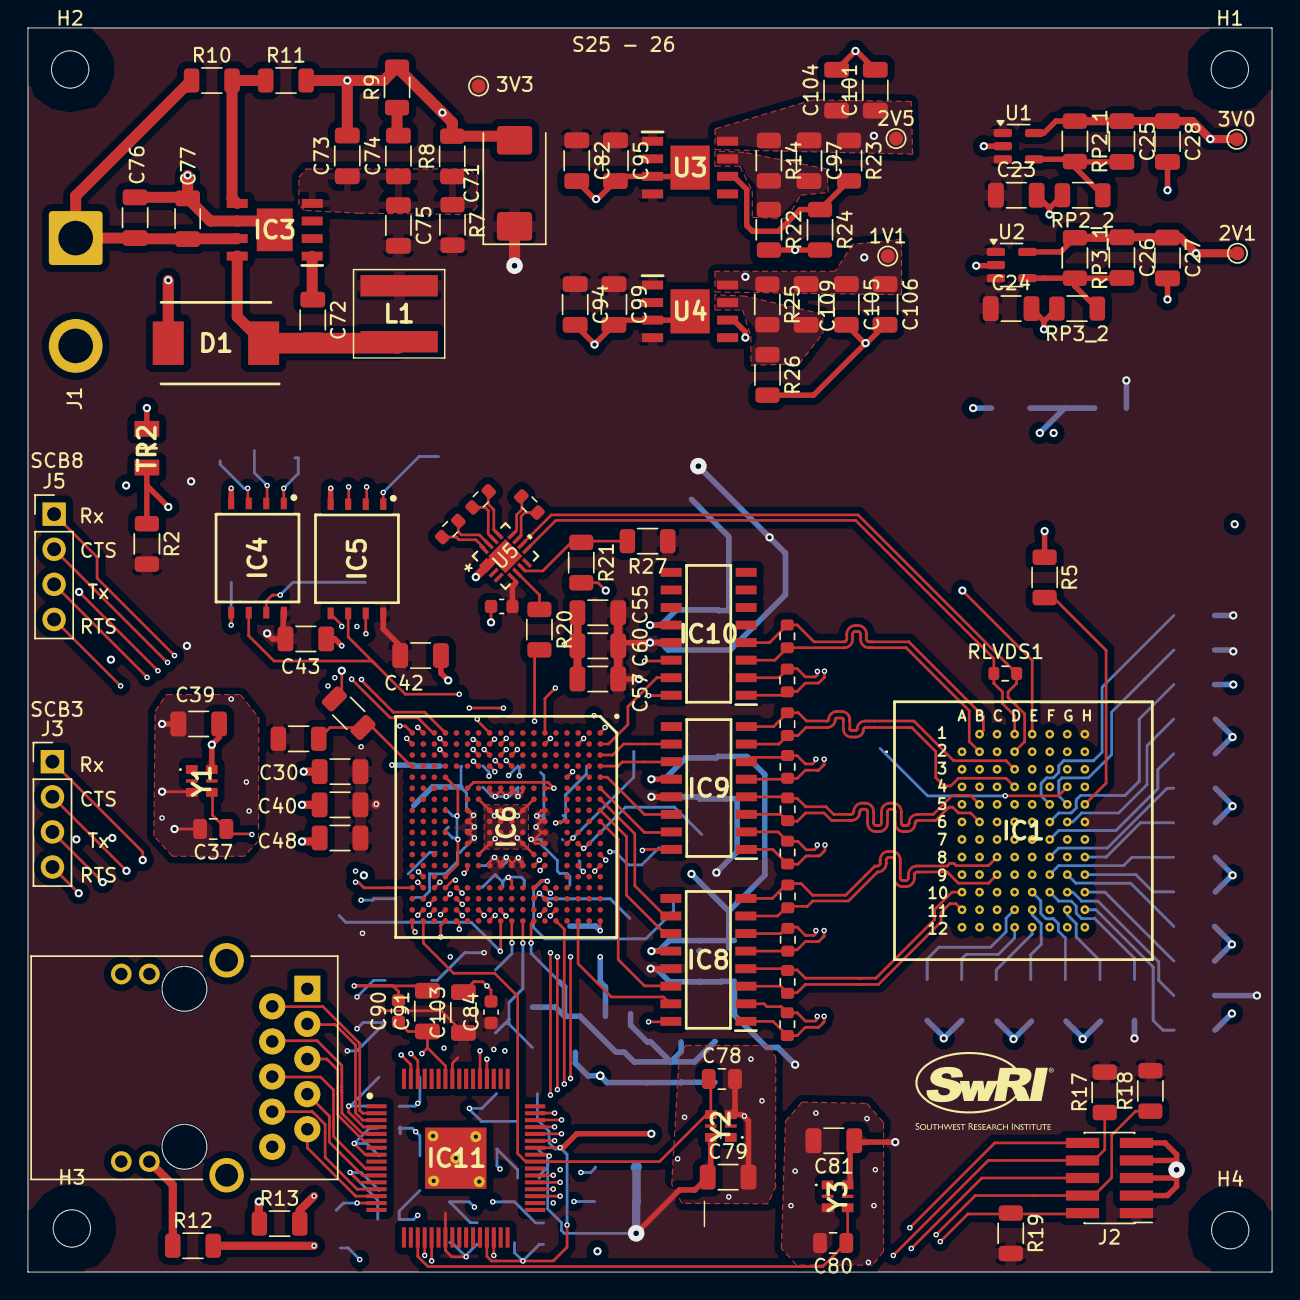
[picture p6: board S25-26.kicad_pcb from above]

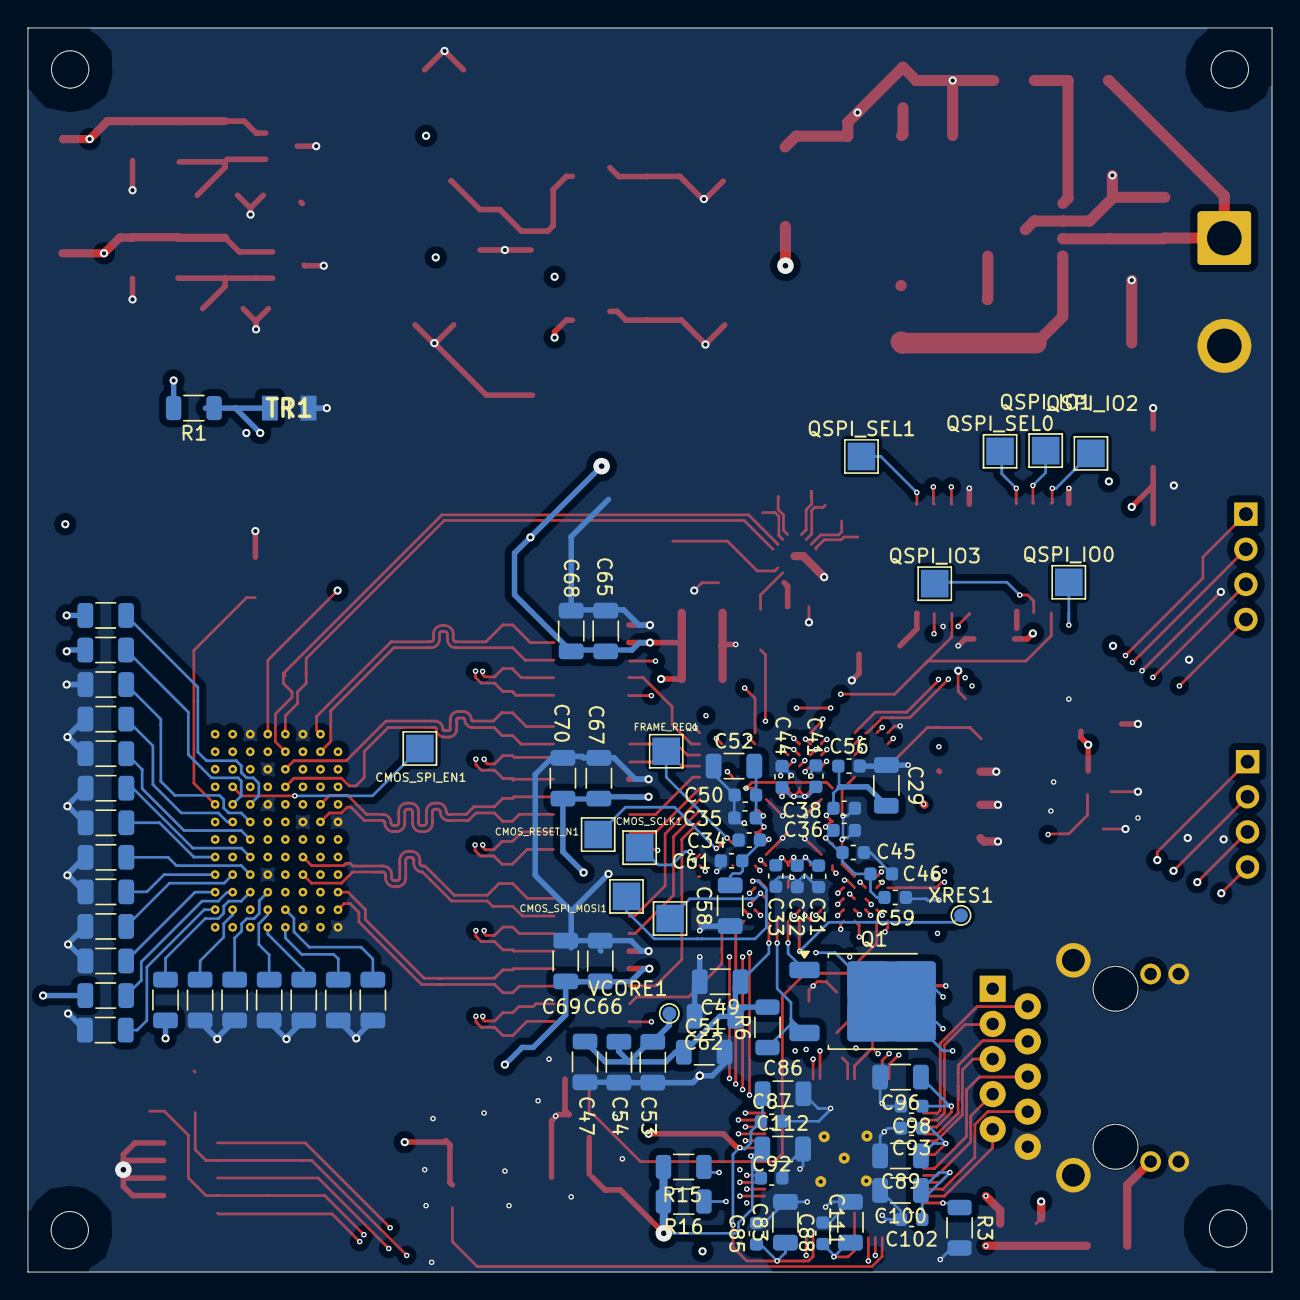
[picture p7: board S25-26.kicad_pcb from below]

Board: 6 copper layers, 90.0 x 90.0 mm, 202 parts (85 on the bottom side), 146 nets.
