S25-26-CMOS-Detector-Readout-System/S25-26-kicad/(commit log)

2024-11-13 Imported ICs
    Imported LVDS Receiver and Driver ICS and Voltage Regulator IC.
2024-11-15 First Draft
    Added Power Regulation, LVDS Serialization, and Processing sheets. Created schematics for voltage regulators and LVDS receivers, including inputs and outputs. Added symbols for all components. Added CMOS detector with LVDS outputs, power inputs, and bias decoupling.
    [LVDS_serialization.kicad_sch, Processing.kicad_sch, S25-26.kicad_sch, power.kicad_sch]
2024-11-18 Ethernet Connections made; SPI connections made; TODO list in processing schem
    [Processing.kicad_sch]
2024-11-22 Corrected LVDS
    [LVDS_serialization.kicad_sch, S25-26.kicad_sch]
2024-11-22 Processing Updates
    Added LVCMOS connections to MCU, added power regulation to MCU (NOT COMPLETE!)
    [Processing.kicad_sch, S25-26.kicad_sch]
2024-11-23 Added lots more connections
    [LVDS_serialization.kicad_sch, Processing.kicad_sch, S25-26.kicad_sch, power.kicad_sch]
2024-12-03 Some Colors; GND net ties
    [Processing.kicad_sch, S25-26.kicad_sch]
2024-12-03 Condensed to one page schematic; added decoupling capacitors on MCU; added CLK connections, currently assuming any PWM pins can act as clkout, docs are rather vague; redid LVDS connections to represe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
    [LVDS_serialization.kicad_sch, Processing.kicad_sch, S25-26.kicad_sch, power.kicad_sch]
2024-12-03 Add some preliminary pin connectors and RJ45; fix some ethernet phy connections
    [S25-26.kicad_sch]
2024-12-23 Voltage Regulator Minor Edits
    Changed how the I/Os of the voltage regulation systems look, using the specific input and output labels.
    [S25-26.kicad_sch]
2024-12-23 Voltage Input Symbols Edited
    Changed into global input/output symbols for easier readability
    [S25-26.kicad_sch]
2025-01-24 Implementing Global Labels
    Swapping generic I/O labels for global labels to help provide clarity in the schematic. Completed Supply Decoupling Caps, Temp. Sensing, Voltage Regulation, and part of Core Ext. Regulator
    [S25-26.kicad_sch]
2025-02-05 Reverted schematic to hierarchical structure.
    The following connections are known to be floating:
    FRAME_REQ
    CMOS_RESET_N
    CMOS_CLK_OUT
    ETH0_RX_ER
    ETH0_ETH_TSU_TIMER_CMP_VAL
    ETH0_TX_ER
    ETH0_REF_CLK
    LVDS_RECV_EN
    [S25-26.kicad_sch, lvds.kicad_sch, processing.kicad_sch, voltage_regulation.kicad_sch]
2025-02-05 Some small revisions
    [S25-26.kicad_sch]
2025-02-05 One gnd to rule them all; PCB border (90 mm x 90 mm)
    [S25-26.kicad_pcb, S25-26.kicad_sch, lvds.kicad_sch, processing.kicad_sch, voltage_regulation.kicad_sch]
2025-02-05 3v3 Regulator routed; zones for 3v3 and gnd
    [S25-26.kicad_pcb, S25-26.kicad_sch, lvds.kicad_sch, processing.kicad_sch, voltage_regulation.kicad_sch]
2025-02-07 Schematic - Component Specifics
    Fixed floating connections.
    Added parameters, footprints, Mouser part numbers, and Mouser links to all symbols, including discrete components and ICs.
    The following symbols do not have Mouser part numbers or Mouser links:
    CMOS Sensor (not required)
    RJ45 Connector
    JTAG Connector
    DC Barrel Jack
    [S25-26.kicad_sch, lvds.kicad_sch, processing.kicad_sch, voltage_regulation.kicad_sch]
2025-02-12 QSPI Lines for 100 MHz channel
    [processing.kicad_sch]
2025-02-12 Some small changes for BOM
    [S25-26.kicad_sch, lvds.kicad_sch, processing.kicad_sch, voltage_regulation.kicad_sch]
2025-02-15 Ethernet Transceiver
    [S25-26.kicad_pcb, S25-26.kicad_sch, lvds.kicad_sch, processing.kicad_sch, voltage_regulation.kicad_sch]
2025-02-17 Memory layout completed
    [S25-26.kicad_pcb, S25-26.kicad_sch, lvds.kicad_sch, processing.kicad_sch, voltage_regulation.kicad_sch]
2025-02-21 Lots of PCB changes, some small parts changes
    Updated parts footprints from those found in MDE Lab. Some parameters may be incorrect, but all footprints should be correct
    Drew most of PCB. CMOS SPI still needs connection. Decoupling caps on MCU still need connection. Power and ground needs to be analyzed, and some components may not have power or ground connected.
    [S25-26.kicad_pcb, S25-26.kicad_sch, lvds.kicad_sch, processing.kicad_sch, voltage_regulation.kicad_sch]
2025-02-24 Adjusted board setup for AdvancedPCB; fixed many DRC errors
    [S25-26.kicad_pcb]
2025-02-24 Fixed DRC; all connections made
    [S25-26.kicad_pcb]
2025-02-26 Testpads everywhere; passives' footprints updated from MDE components; bigger DC_IN pads
    [S25-26.kicad_pcb, S25-26.kicad_sch, lvds.kicad_sch, processing.kicad_sch, voltage_regulation.kicad_sch]
2025-02-27 move toplevel to accomadate test pads
    [S25-26.kicad_sch]
2025-02-28 Final Changes before Order
    [S25-26-B_Cu.gbr, S25-26-B_Mask.gbr, S25-26-B_Paste.gbr, S25-26-B_Silkscreen.gbr, S25-26-Edge_Cuts.gbr, S25-26-F_Cu.gbr, S25-26-F_Mask.gbr, S25-26-F_Paste.gbr]
2025-03-05 Watch Out: David's Mounting Holes
    [S25-26.kicad_pcb, S25-26.kicad_sch]
2025-03-25 Lots of small changes
    Some power and ground planes need to be looked at
    All parts need to be reexamined before ordering
    [S25-26.kicad_pcb, S25-26.kicad_sch, lvds.kicad_sch, processing.kicad_sch, voltage_regulation.kicad_sch]
2025-03-25 See previous push
    [S25-26.kicad_pcb, S25-26.kicad_sch]
2025-03-26 Added text to pinheaders for JTAG and UART
    [S25-26.kicad_pcb]
2025-03-27 Almost done
    Taking a break and making a push. Known things to do:
    Add pull-up resistors to ETH MDIO, ETH MDC, and XRESL.
    Source a 100uF capacitor for primary regulator.
    [S25-26.kicad_pcb, S25-26.kicad_sch, lvds.kicad_sch, processing.kicad_sch, voltage_regulation.kicad_sch]
2025-03-28 Ready to order
    Still unsure about 100uF cap
    [S25-26.kicad_pcb, processing.kicad_sch]
2025-03-28 Labeled test pads; marked tantalums with lines for cathode; found suitable tantalum for 100 uF
    [S25-26.kicad_pcb, S25-26.kicad_sch, processing.kicad_sch, voltage_regulation.kicad_sch]
2025-03-28 S25 - 26 Text Added
    [S25-26.kicad_pcb]
2025-03-29 Some teeny changes
    [S25-26.kicad_pcb]
2025-04-02 CMOS Sensor Grid Text
    [S25-26.kicad_pcb]
2025-04-18 Beginning of V3
    Long way to go
    [S25-26.kicad_pcb, S25-26.kicad_sch, processing.kicad_sch]
2025-04-19 Excluded TPs from BOM
    [S25-26.kicad_pcb, S25-26.kicad_sch, processing.kicad_sch]
2025-04-22 V3 Overhaul
    Things remaining:
    Ethernet Transceiver Clocks
    Output Filtering on DC-DC Converter
    Update some part numbers
    [S25-26.kicad_pcb, S25-26.kicad_sch, processing.kicad_sch, voltage_regulation.kicad_sch]
2025-04-22 Some mild V3 changes
    [S25-26.kicad_pcb, S25-26.kicad_sch, processing.kicad_sch]
2025-04-24 V3 Almost Final
    Move LVDS driver/change part if decided
    Add thermal vias to GND pads of LDOs and ETH PHY.
    [S25-26.kicad_pcb, processing.kicad_sch]
2025-04-30 Keepouts on mounting holes, QSPI on different lines, new LVDS clock buffer, voltage sense circuit
    [S25-26.kicad_pcb, S25-26.kicad_sch, processing.kicad_sch, voltage_regulation.kicad_sch]
